surfmichal/Sterowanie-Grzalkami-3f-bojler-pv/Hardware/Sterownik grzałek 3f - pf v8.pdf

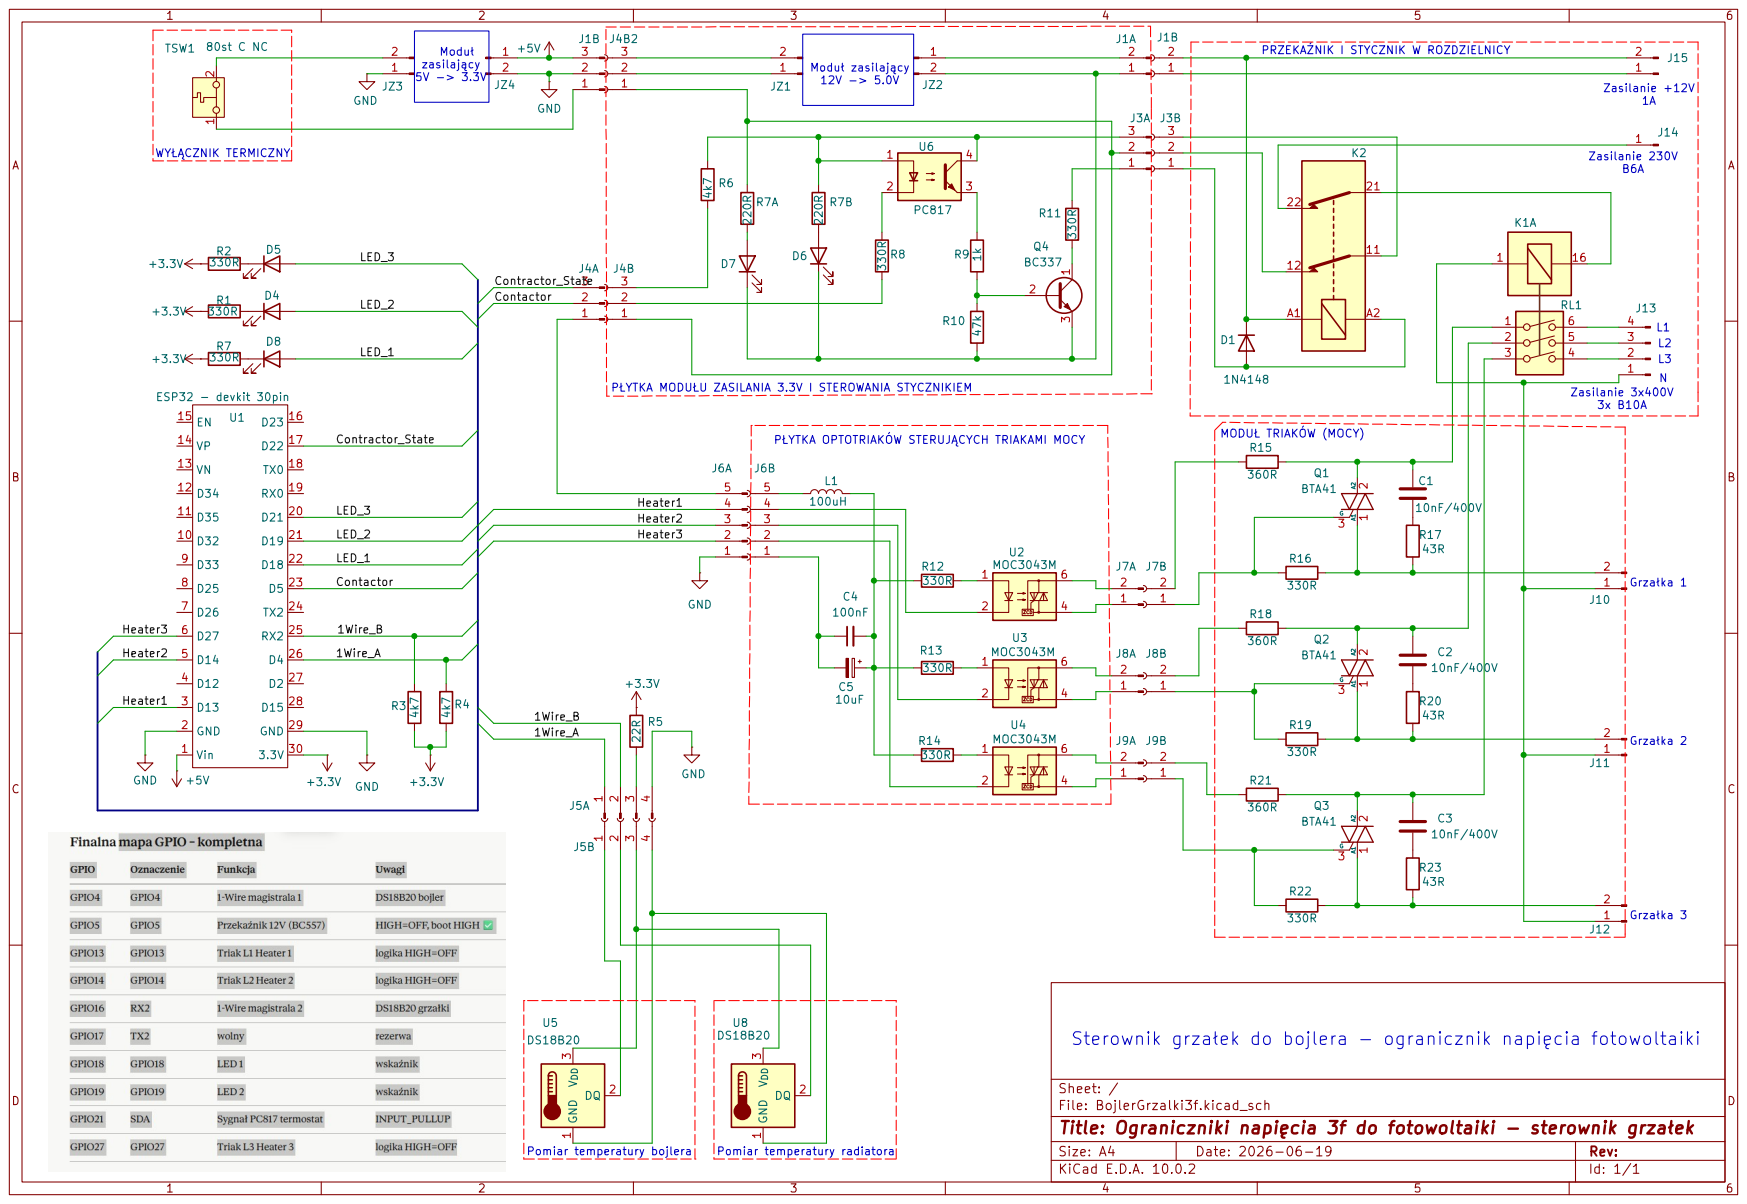
[picture p1: page 1]
