surfmichal/Sterowanie-Grzalkami-3f-bojler-pv/Hardware/Sterownik grzałek 3f - pf v7.pdf

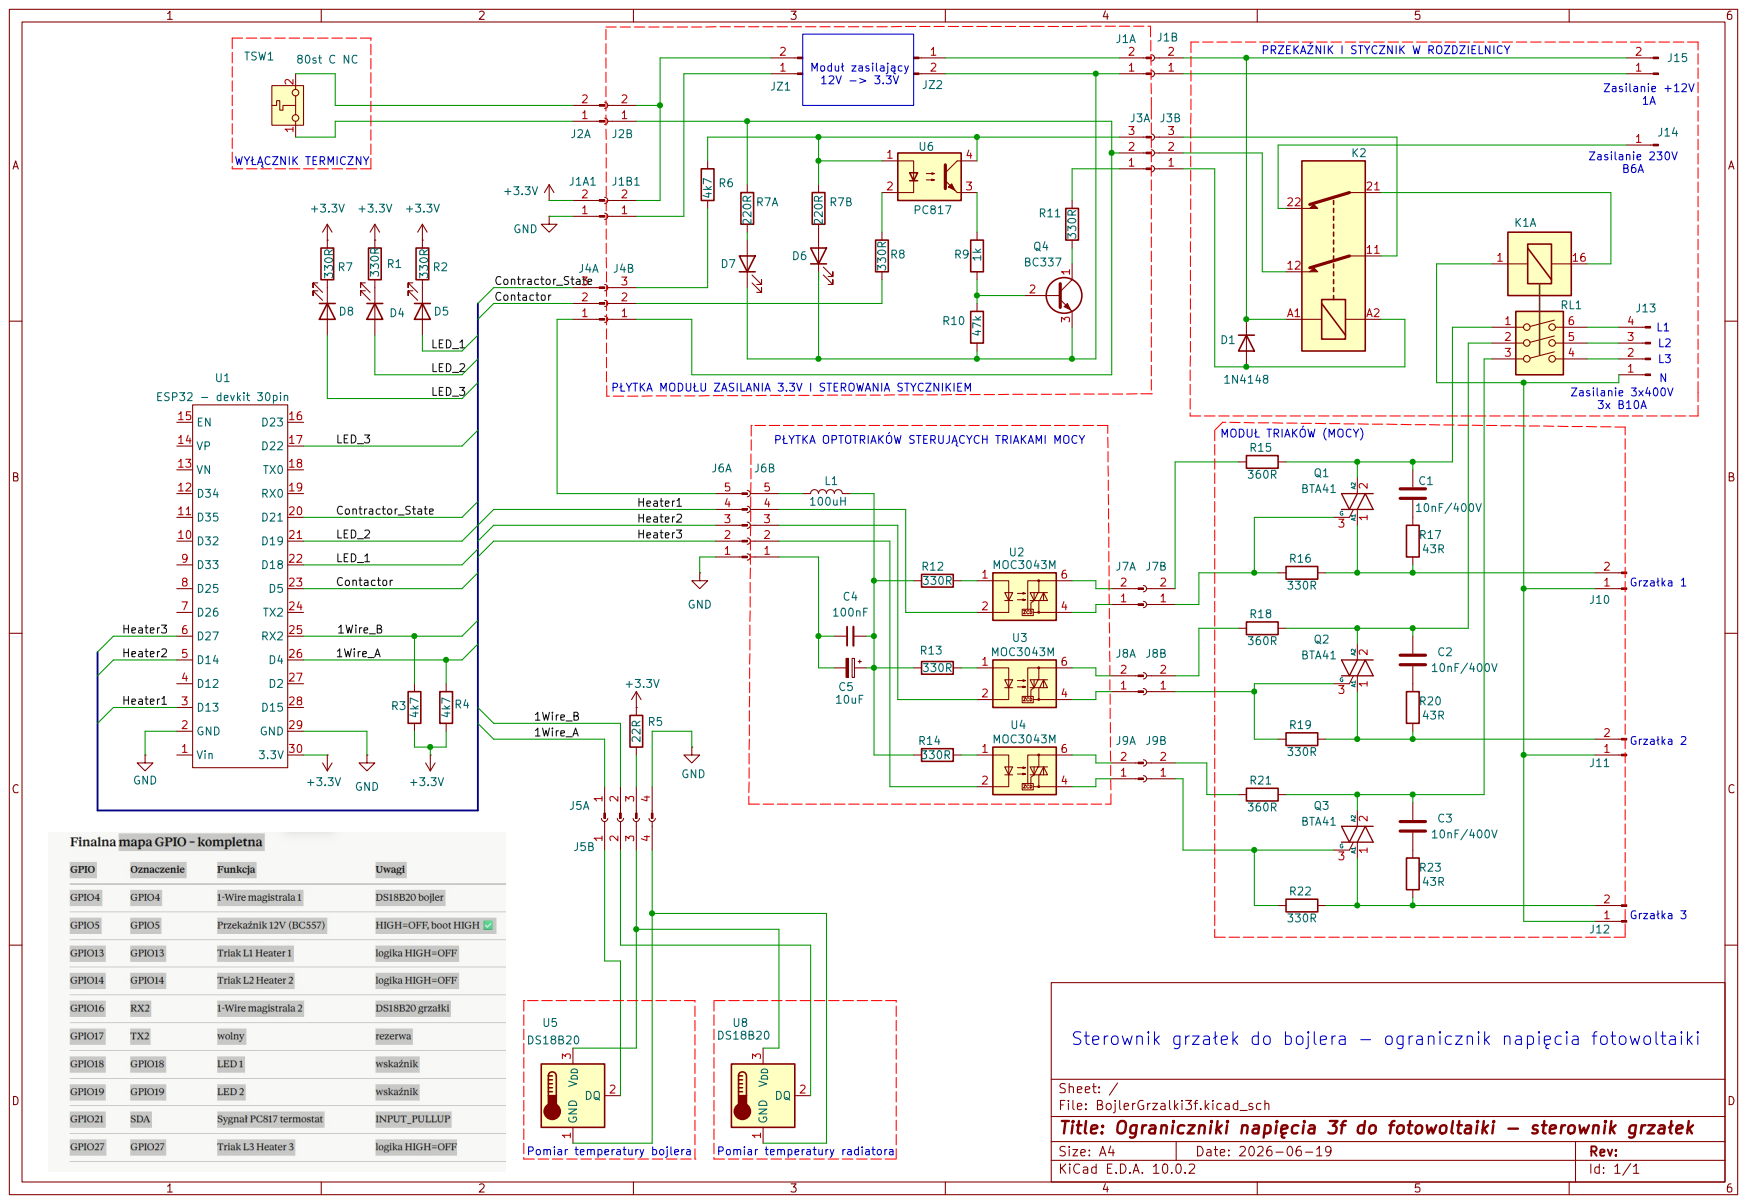
[picture p2: page 1]
