surfmichal/Sterowanie-Grzalkami-3f-bojler-pv/Hardware/Sterownik grzałek 3f - pf v6.pdf

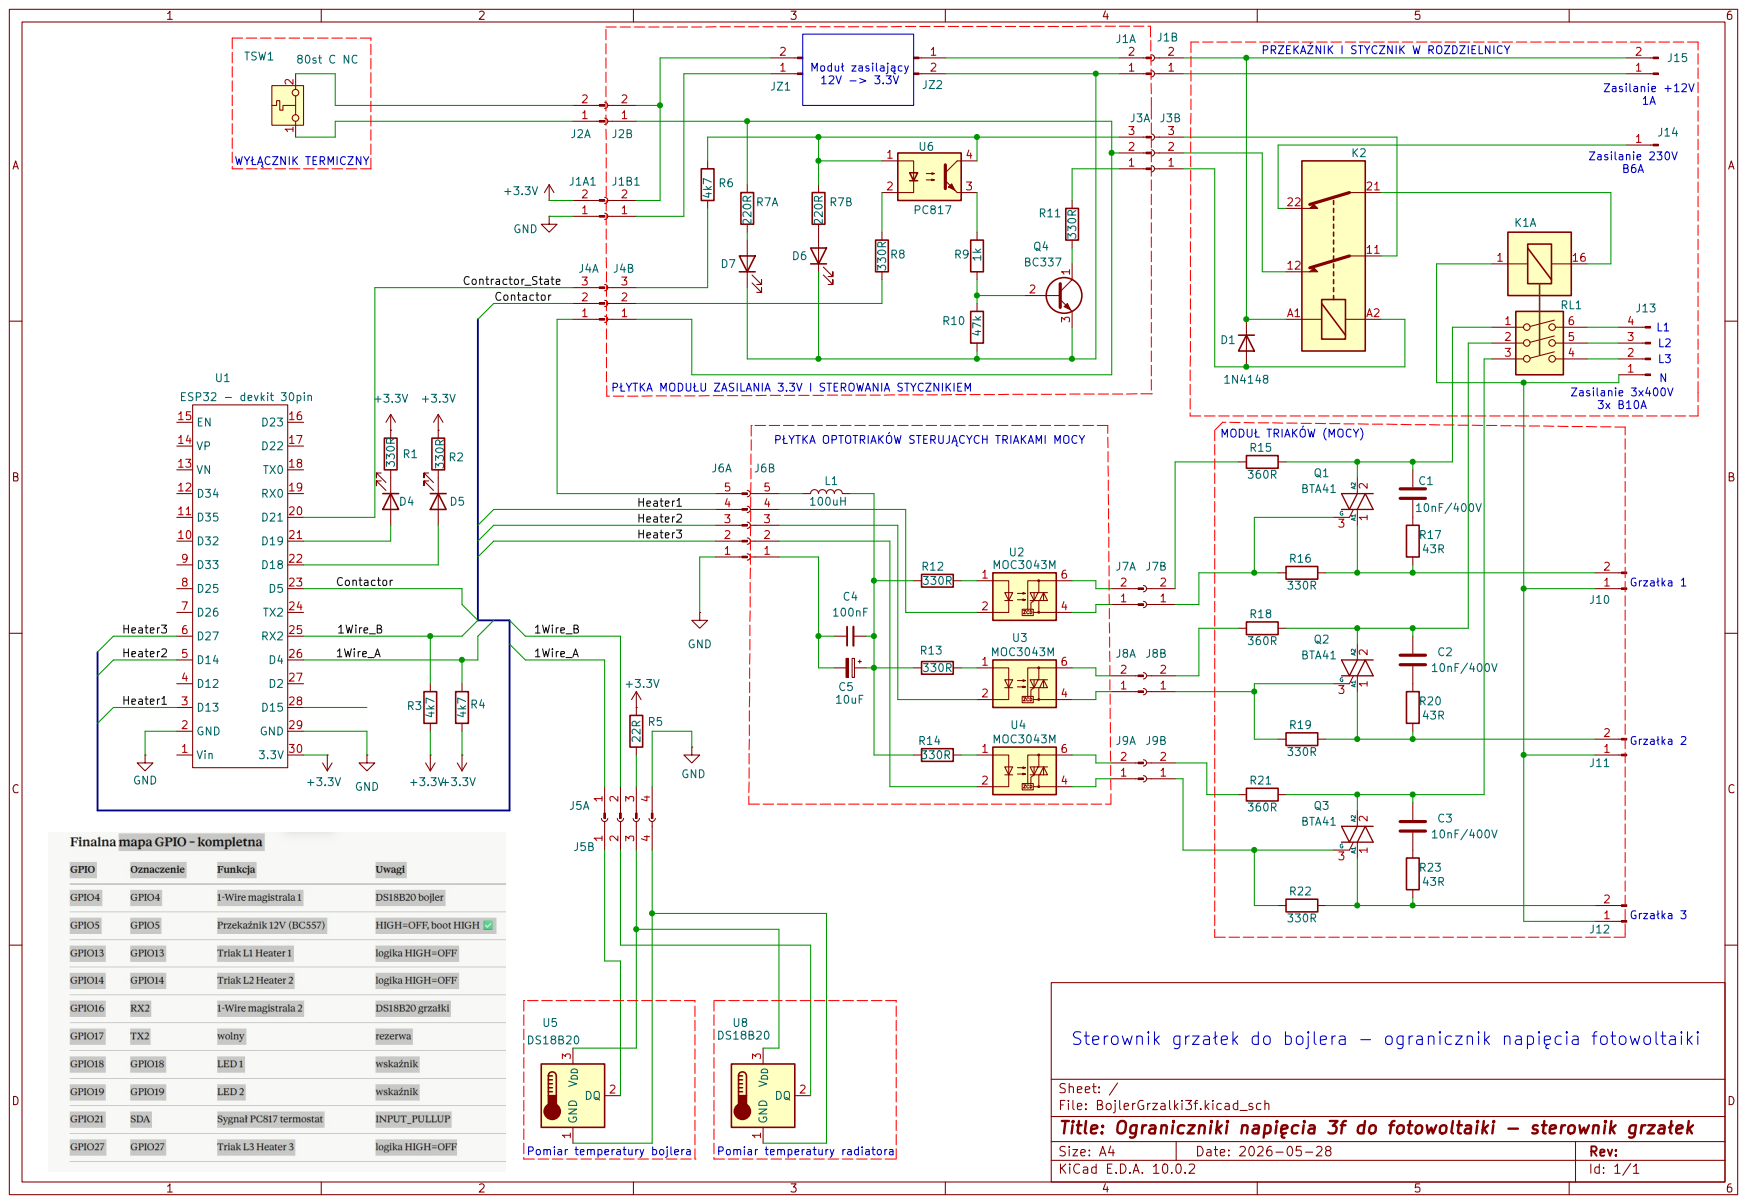
[picture p3: page 1]
