surfmichal/Sterowanie-Grzalkami-3f-bojler-pv/Hardware/Sterownik grzałek 3f - pf v5.pdf

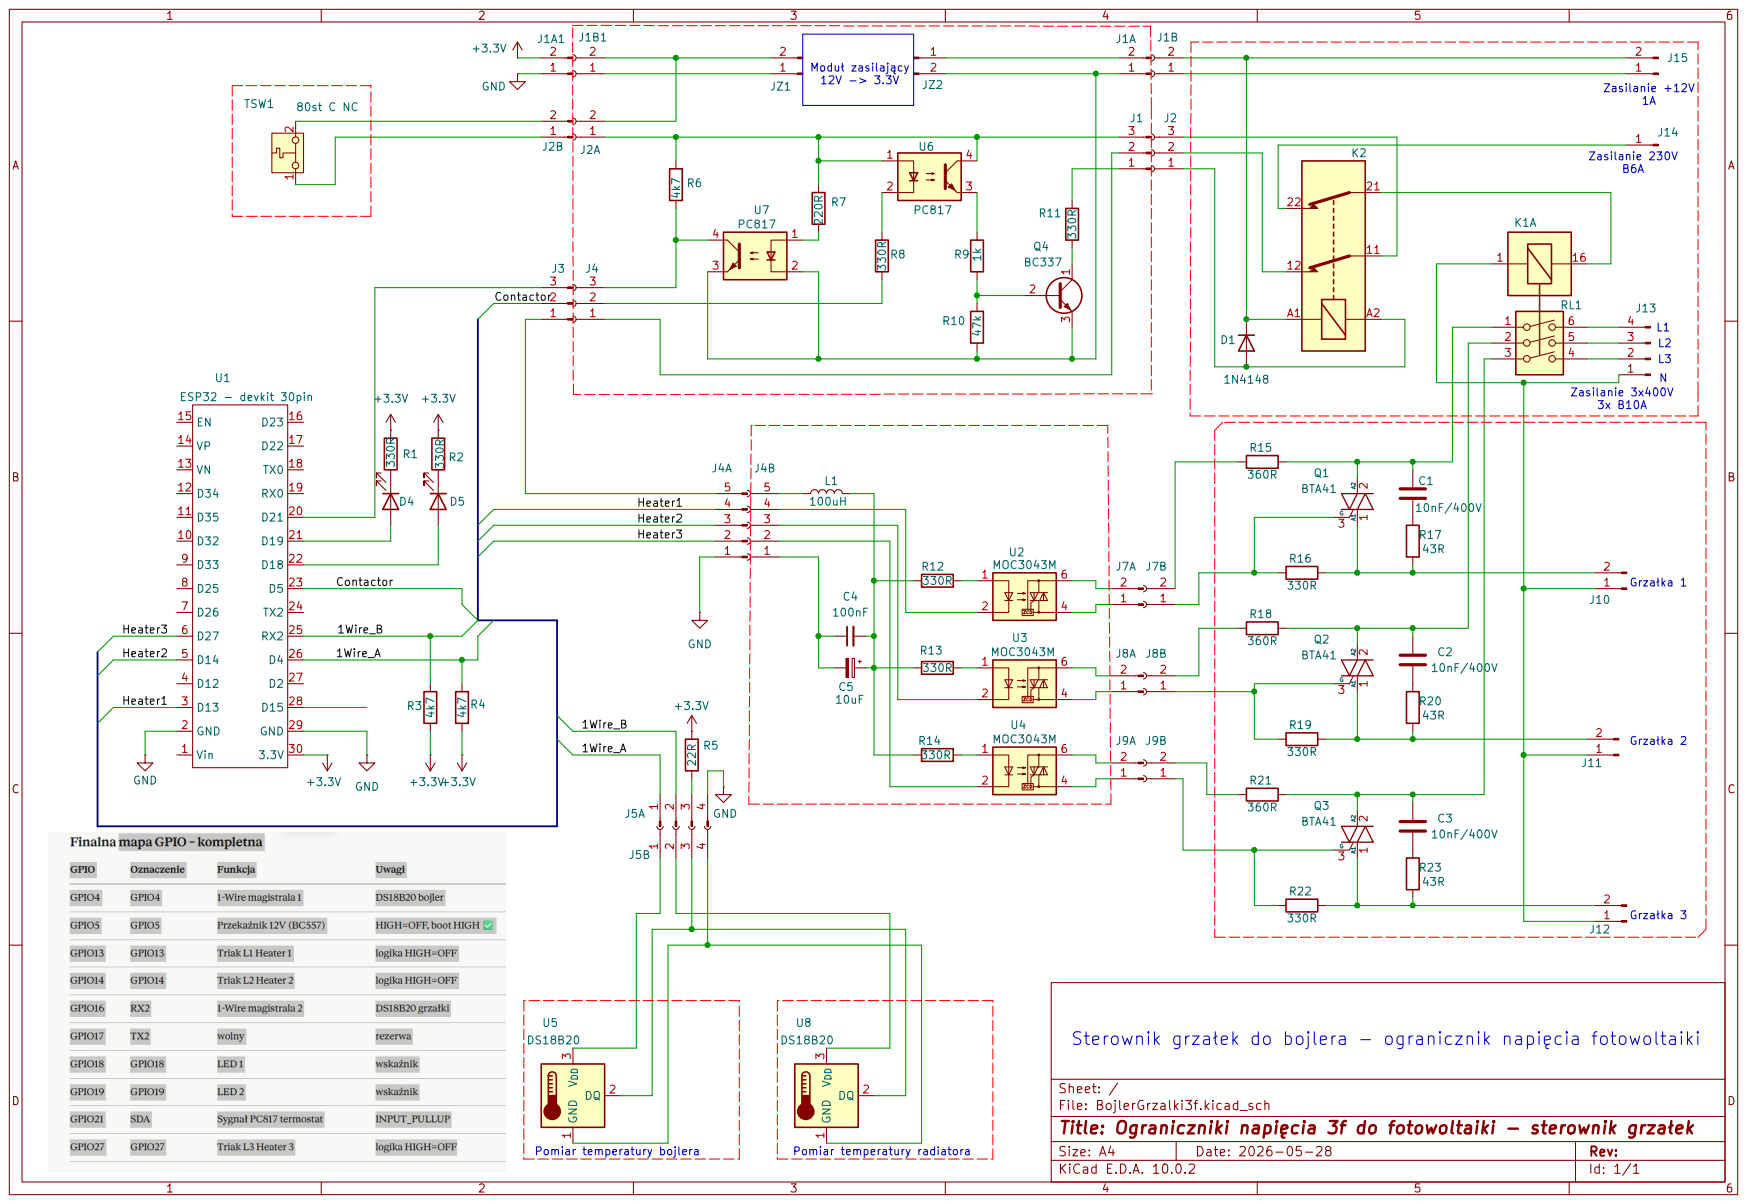
[picture p4: page 1]
