surfmichal/Sterowanie-Grzalkami-3f-bojler-pv/Hardware/Sterownik grzałek 3f - pf v4.pdf

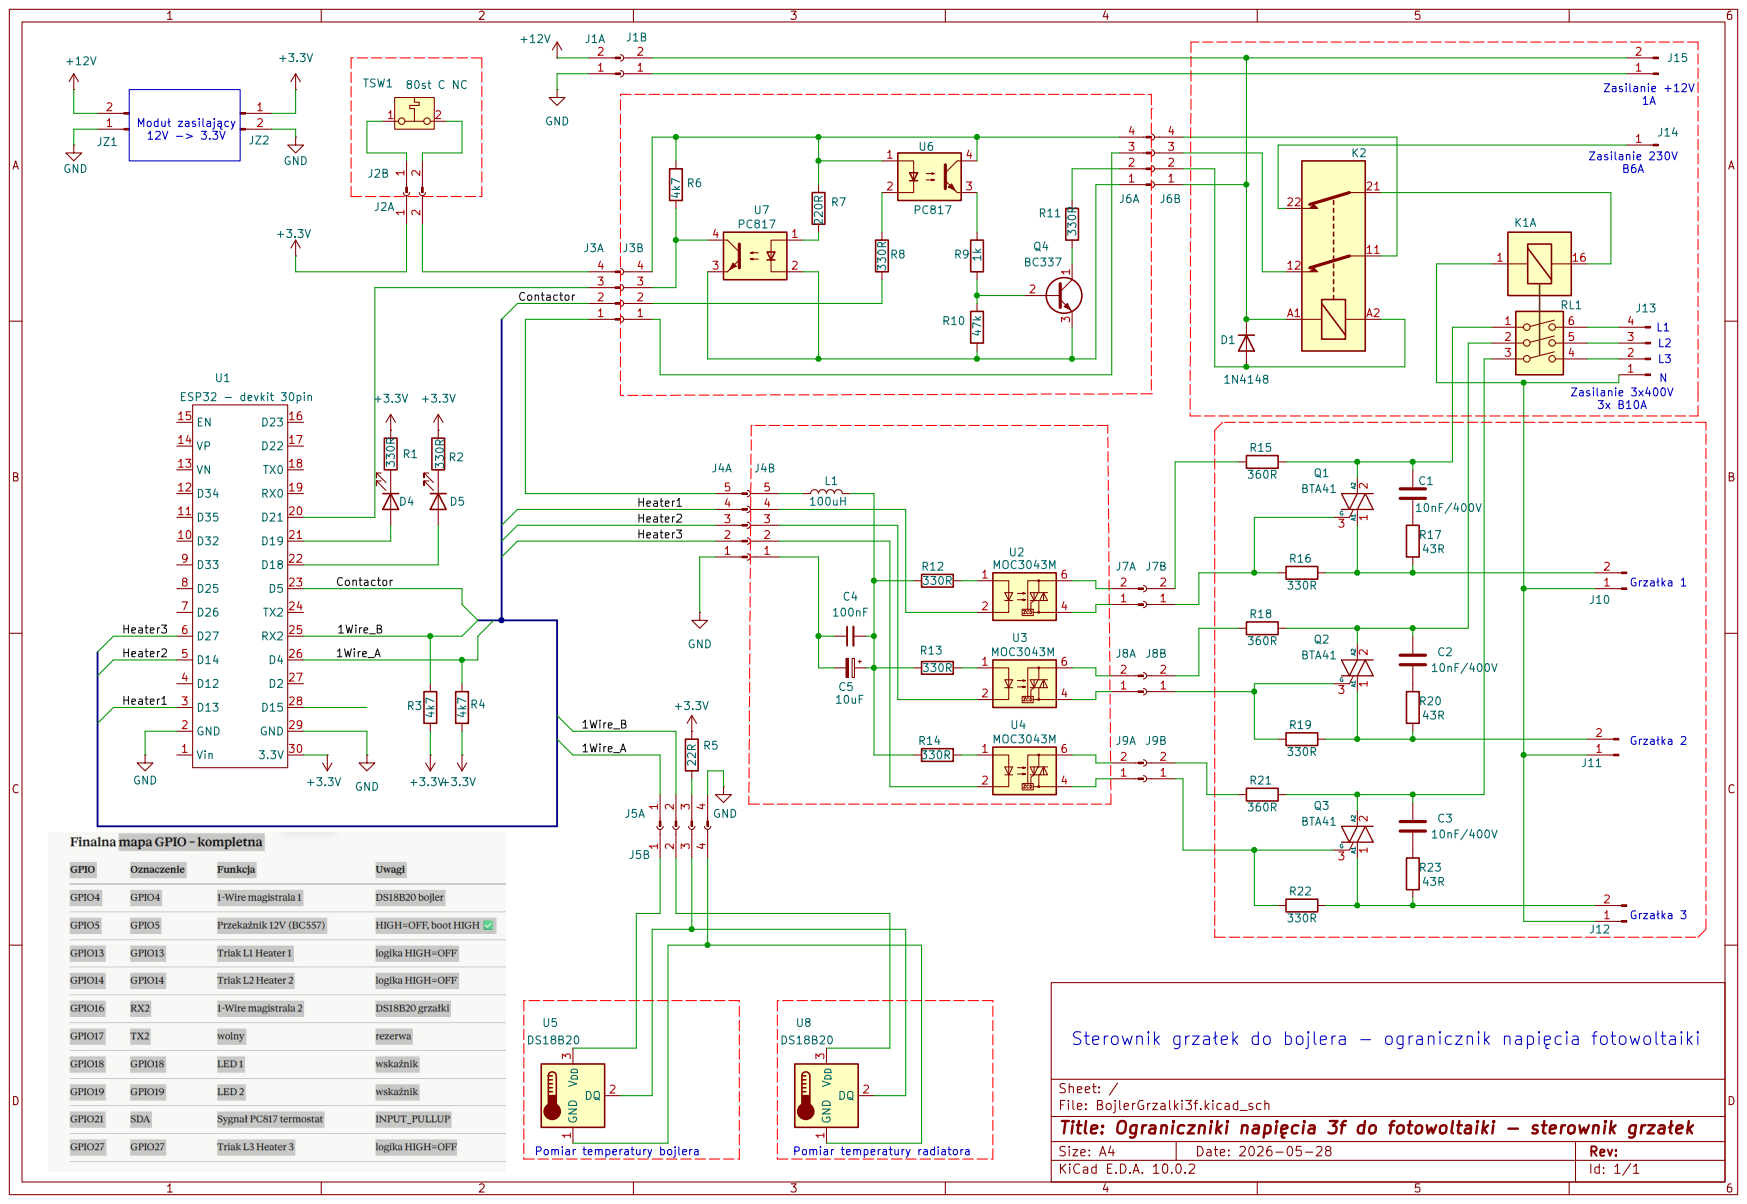
[picture p5: page 1]
