surfmichal/Sterowanie-Grzalkami-3f-bojler-pv/Hardware/BojlerGrzalki3f.kicad_sch

## KiCad design Hardware/BojlerGrzalki3f.kicad_sch (2026-06-11)

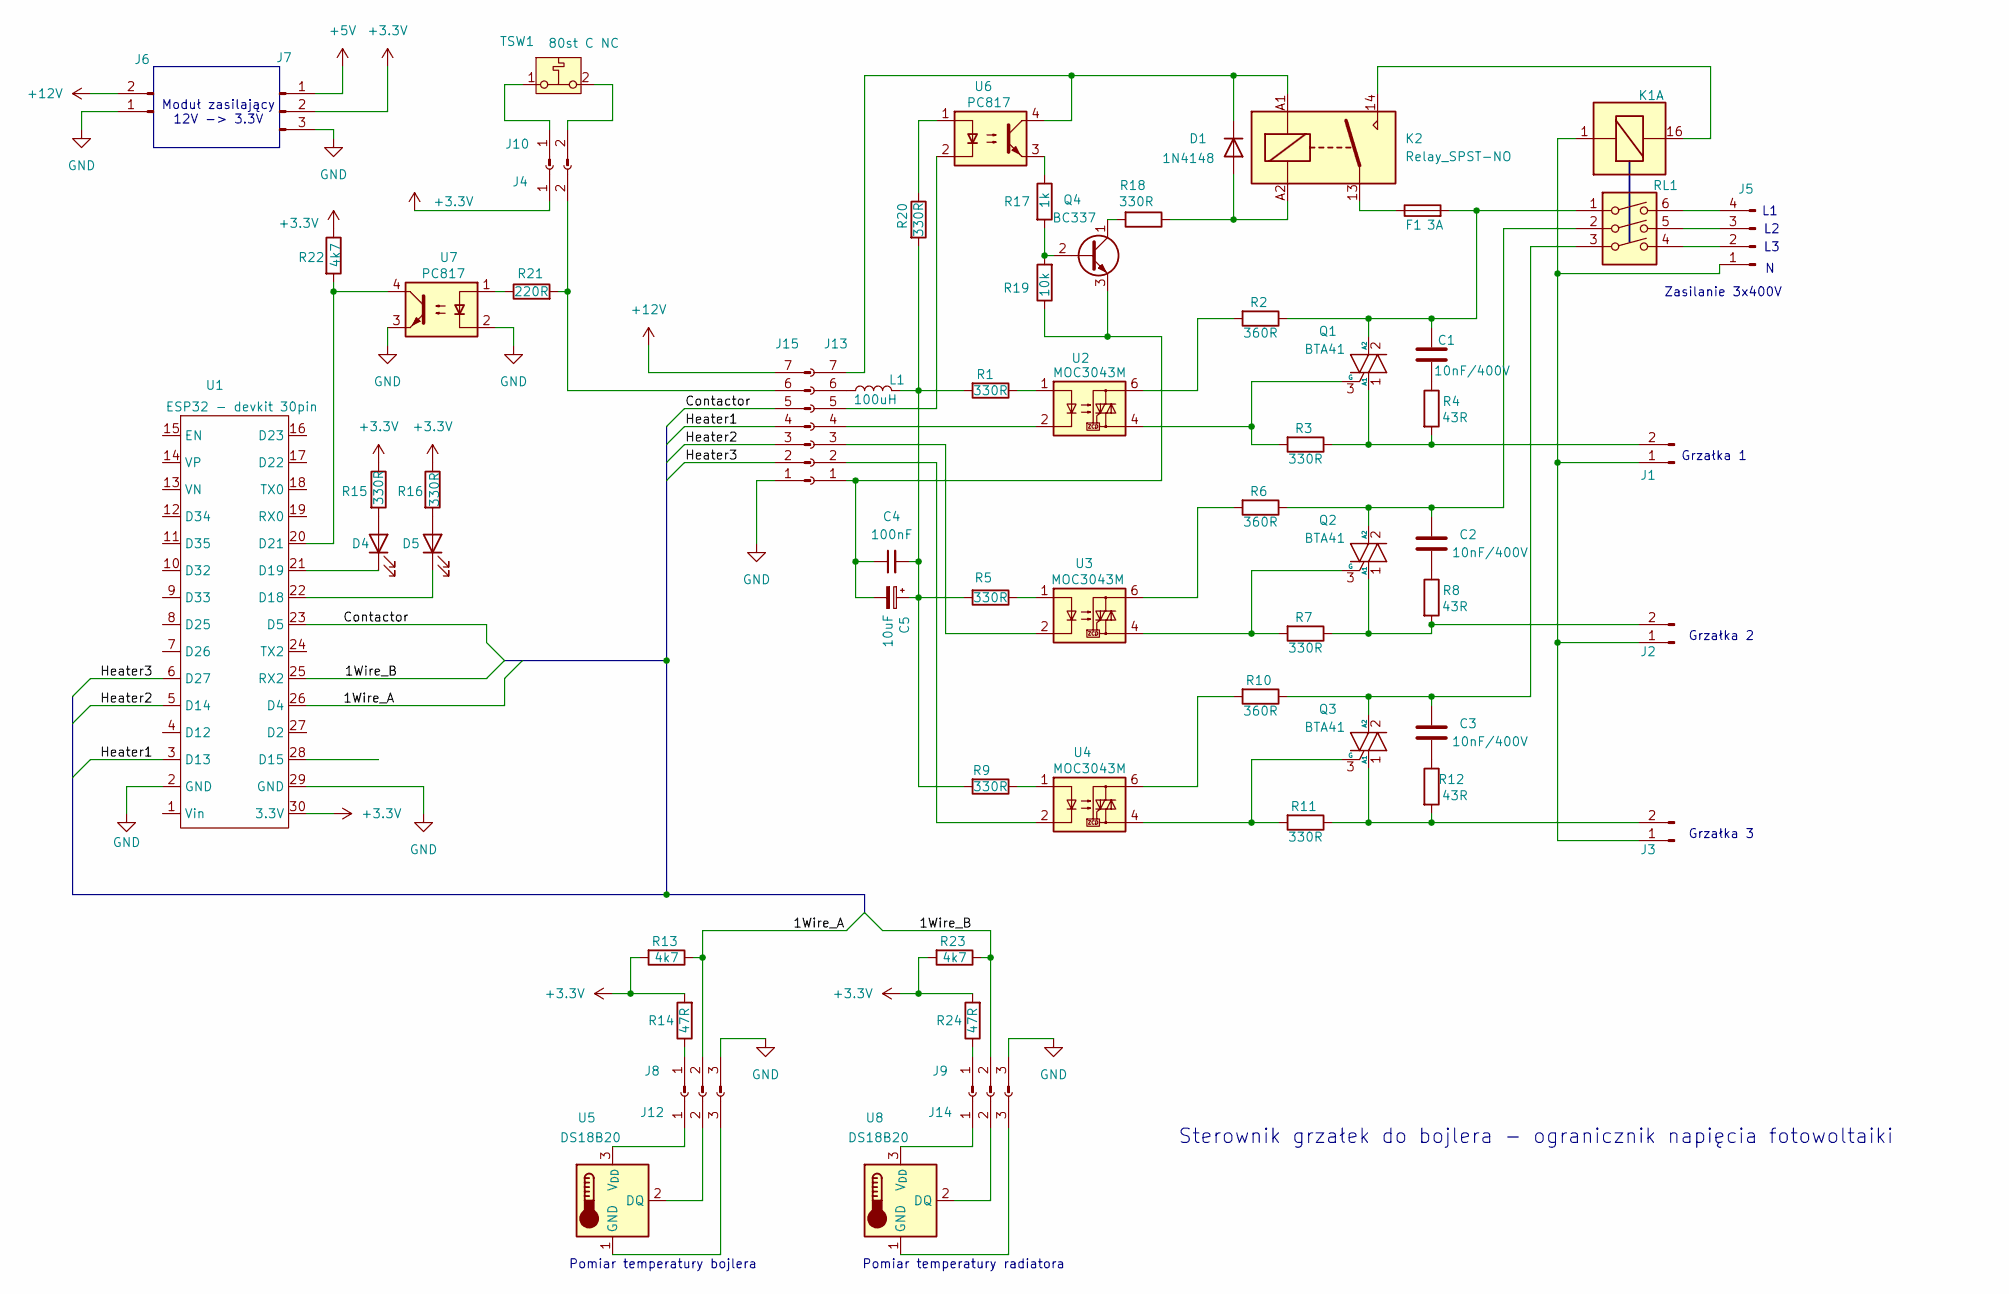
[picture p6: schematic BojlerGrzalki3f.kicad_sch]

Parts:
C1, C2, C3: 10nF/400V
C4: 100nF
C5: 10uF
D1: 1N4148; D_DO-35_SOD27_P7.62mm_Horizontal
D4, D5: LED
F1: 3A
J1, J2, J3, J6, J10: Conn_01x02_Pin
J4: Conn_01x02_Socket
J5: Conn_01x04_Pin
J7, J8, J9: Conn_01x03_Pin
J12, J14: Conn_01x03_Socket
J13: Conn_01x07_Pin
J15: Conn_01x07_Socket
K1: G5V-2_Split; Relay_DPDT_Omron_G5V-2
K2: Relay_SPST-NO
L1: 100uH
Q1, Q2, Q3: BTA41; TO-220-3_Vertical
Q4: BC337; TO-92_Inline
R1, R3, R5, R7, R9, R11, R15, R16, R18, R20: 330R
R2, R6, R10: 360R
R4, R8, R12: 43R
R13, R22, R23: 4k7
R14, R24: 47R
R17: 1k
R19: 10k
R21: 220R
RL1: SW_DIP_x03
TSW1: 80st C NC
U1: ESP32 - devkit 30pin
U2, U3, U4: MOC3043M
U5, U8: DS18B20; TO-92_Inline
U6, U7: PC817; DIP-4_W7.62mm

Connections:
1Wire_A: J8.2, R13.1, U1.26 (D4)
1Wire_B: J9.2, R23.1, U1.25 (RX2)
+3.3V: J4.1, J7.2, R13.2, R14.2, R15.1, R16.1, R22.1, R23.2, R24.2, U1.30 (3.3V)
+5V: J7.1
+12V: J6.2, J13.7
Contactor: J13.5, U1.23 (D5)
GND: J6.1, J7.3, J8.3, J9.3, J13.1, U1.2 (GND), U1.29 (GND), U7.2, U7.3
Heater1: J13.4, U1.3 (D13)
Heater2: J13.3, U1.5 (D14)
Heater3: J13.2, U1.6 (D27)
unnamed: C1.1, F1.2, Q1.2 (A2), R2.1, RL1.1
unnamed: C1.2, R4.1
unnamed: C2.1, Q2.2 (A2), R6.1, RL1.2
unnamed: C2.2, R8.1
unnamed: C3.1, Q3.2 (A2), R10.1, RL1.3
unnamed: C3.2, R12.1
unnamed: C4.1, C5.2, J15.1, Q4.3 (E), R19.1
unnamed: C4.2, C5.1, L1.2, R1.2, R5.2, R9.2, R20.2
unnamed: D1.1 (K), J15.7, K2.A1, U6.4
unnamed: D1.2 (A), K2.A2, R18.1
unnamed: D4.1 (K), U1.21 (D19)
unnamed: D4.2 (A), R15.2
unnamed: D5.1 (K), U1.22 (D18)
unnamed: D5.2 (A), R16.2
unnamed: F1.1, K2.13
unnamed: J1.1, J2.1, J3.1, J5.1, K1.1
unnamed: J1.2, Q1.1 (A1), R3.1, R4.2
unnamed: J2.2, Q2.1 (A1), R7.1, R8.2
unnamed: J3.2, Q3.1 (A1), R11.1, R12.2
unnamed: J5.2, RL1.4
unnamed: J5.3, RL1.5
unnamed: J5.4, RL1.6
unnamed: J8.1, R14.1
unnamed: J9.1, R24.1
unnamed: J10.1, TSW1.1
unnamed: J10.2, TSW1.2
unnamed: J12.1, U5.3 (V_{DD})
unnamed: J12.2, U5.2 (DQ)
unnamed: J12.3, U5.1 (GND)
unnamed: J4.2, J13.6, R21.2
unnamed: J14.1, U8.3 (V_{DD})
unnamed: J14.2, U8.2 (DQ)
unnamed: J14.3, U8.1 (GND)
unnamed: J15.2, U4.2
unnamed: J15.3, U3.2
unnamed: J15.4, U2.2
unnamed: J15.5, U6.2
unnamed: J15.6, L1.1
unnamed: K1.16, K2.14
unnamed: Q1.3 (G), R3.2, U2.4
unnamed: Q2.3 (G), R7.2, U3.4
unnamed: Q3.3 (G), R11.2, U4.4
unnamed: Q4.1 (C), R18.2
unnamed: Q4.2 (B), R17.2, R19.2
unnamed: R1.1, U2.1
unnamed: R2.2, U2.6
unnamed: R5.1, U3.1
unnamed: R6.2, U3.6
unnamed: R9.1, U4.1
unnamed: R10.2, U4.6
unnamed: R17.1, U6.3
unnamed: R20.1, U6.1
unnamed: R21.1, U7.1
unnamed: R22.2, U1.20 (D21), U7.4

Notes on the sheet:
Pomiar temperatury radiatora
Pomiar temperatury bojlera
Grzałka 1
Zasilanie 3x400V
Grzałka 3
Moduł zasilający 12V -> 3.3V
Grzałka 2
Sterownik grzałek do bojlera - ogranicznik napięcia fotowoltaiki
