surfmichal/Sterowanie-Grzalkami-3f-bojler-pv/(commit log)

2026-06-11 Pierwszy commit - schemat sterowania w Kicad
    [BojlerGrzalki3f.kicad_pcb, BojlerGrzalki3f.kicad_sch]
2026-06-11 Reoraganizacja - pliki kicad do folderu Hardware
    [BojlerGrzalki3f.kicad_pcb, BojlerGrzalki3f.kicad_sch]
2026-06-16 wgranie projektu software
    [BojlerGrzalki3f.kicad_pcb, BojlerGrzalki3f.kicad_sch, custom_ota.csv]
2026-06-18 poprawiono ustawianie flag grzałek w heater_control.cpp w begin
2026-06-22 Zmiana zasialania 12V->5V->3.3V
2026-07-13 Poprawiono index.html, settigns.html i zmienną power
2026-07-15 Poprawki w temperature_fifo, dodano zmienną temperatureLogInterval
